PrimbotTech/primbot-q1-diy-shell/README.md

# primbot-q1-diy-shell
STEP reference model and design guide for customizing and fabricating DIY shells for the Primbot Q1 personal robot.
