PrimbotTech/primbot-q1-diy-shell/(list of files, cad)

Other CAD files:
models/Q1-V3.0-整机外壳模型.STEP
